AcheronProject/KeebsPCB/README.md

# Acheron 60-SM-S-STM32-MXH-TH-WI (Codename "KeebsPCB")

Acheron Logo

See [this page](https://gondolindrim.github.io/AcheronDocs/keebs/intro.html) for the KeebsPCB documentation.

## Supported layouts

Click [this link](http://www.keyboard-layout-editor.com/#/gists/73be427d3e8086a9253feece2dae6974) for the KLE file for the KeebsPCB.

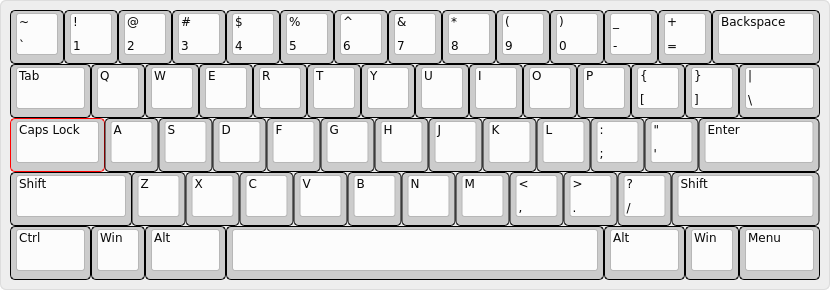
[picture p1: graphics/KLE/keebspcbKLE.png]
Austin layouts


## Renders

Click at the images to zoom in.

Renders generated by the [tracespace.io](https://tracespace.io/view/) site.

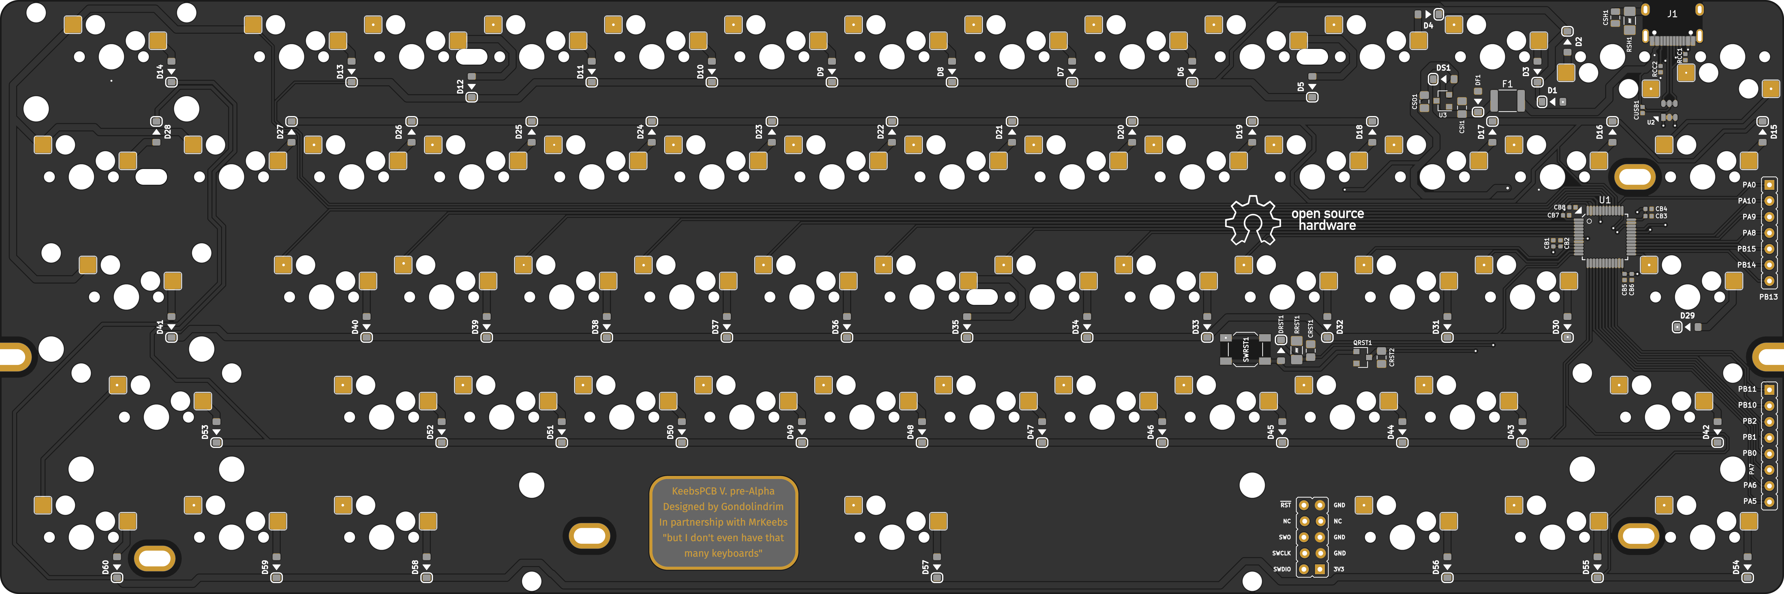
[picture p2: graphics/renders/top.png]
ArcticPCB Top Render


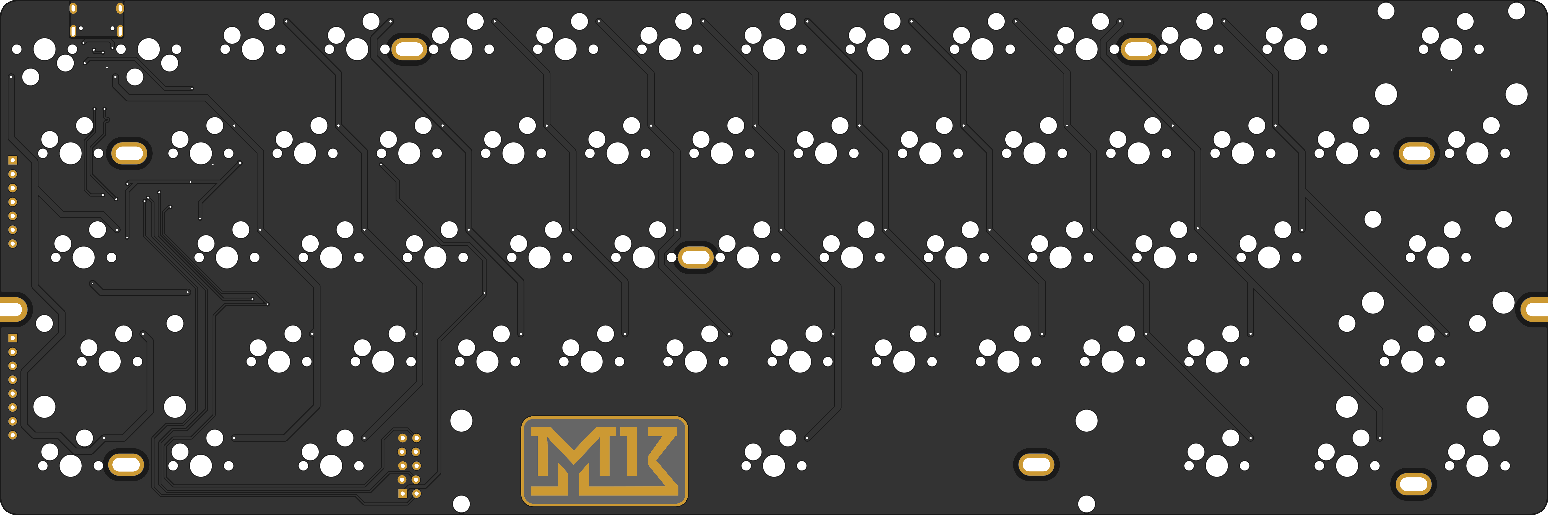
[picture p3: graphics/renders/bottom.png]
ArcticPCB Bottom Render


## Copyright notice

This project is released under the Acheron Open-Hardware License V1.1. For the license, please refer to the LICENCE.md file.
