AcheronProject/KeebsPCB/graphics/keebsLabel/keebsLabel.png

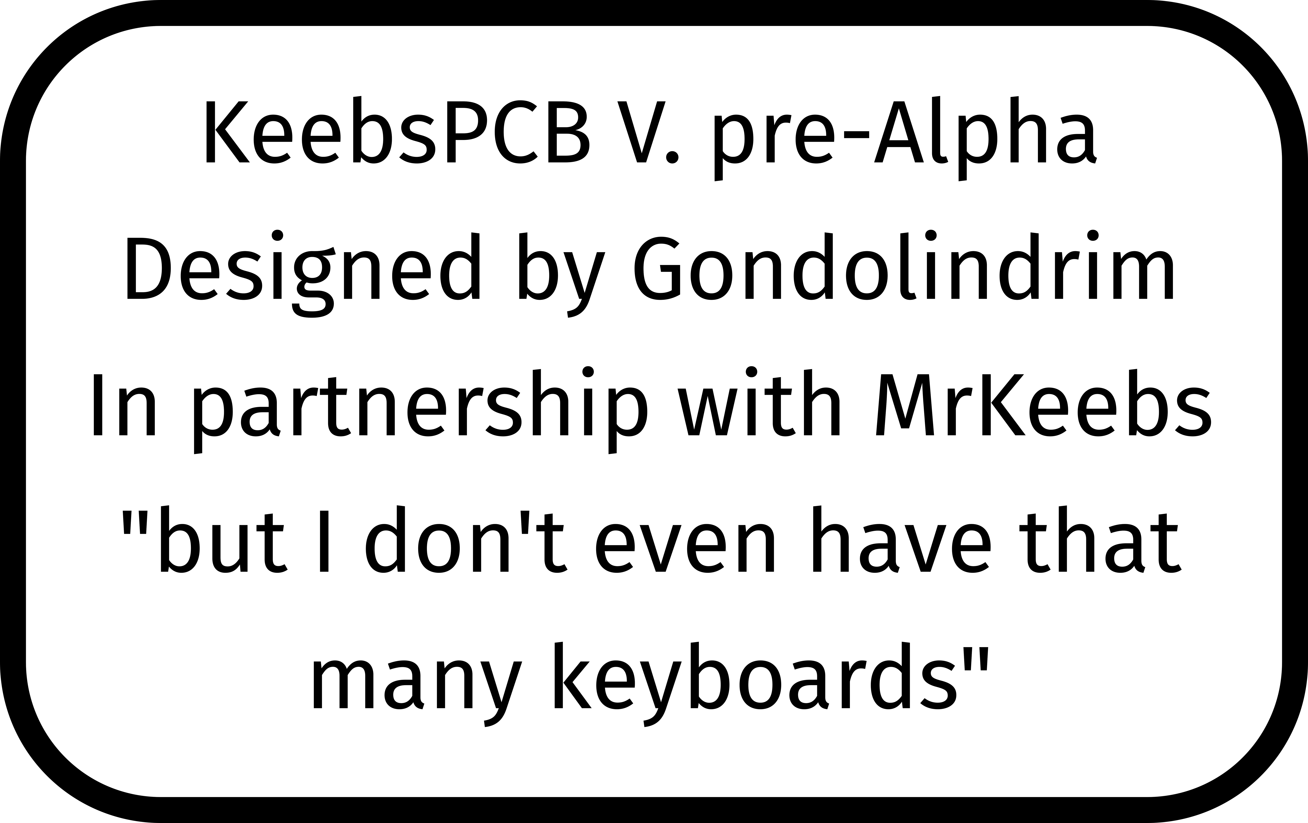
graphics/keebsLabel/keebsLabel.png
