AcheronProject/KeebsPCB/graphics/keebsLabel/keebsLabelMask.png

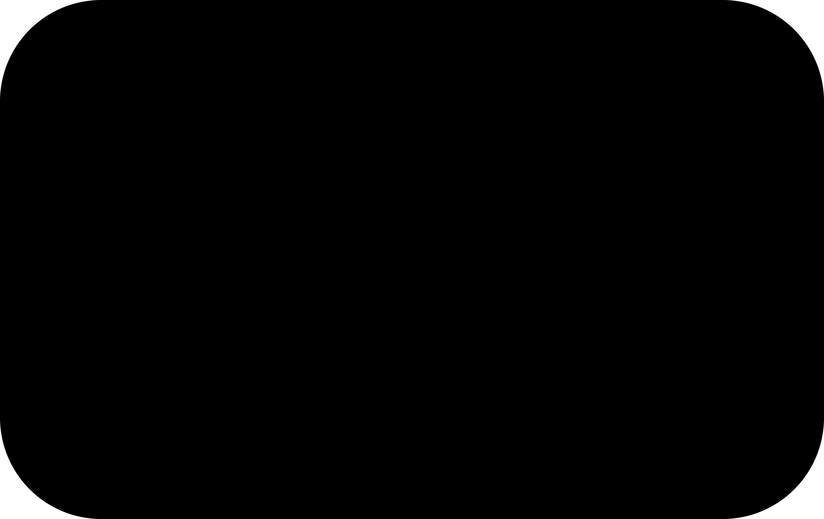
graphics/keebsLabel/keebsLabelMask.png
