AcheronProject/KeebsPCB/resources/keyboardTempEnlarged.dxf

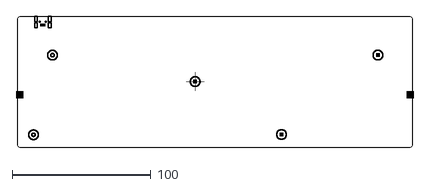
[picture p6: CAD file, 2019-07-31]
resources/keyboardTempEnlarged.dxf
287.2 x 94.7
