AcheronProject/KeebsPCB/resources/60_Keyboard_Case.stl

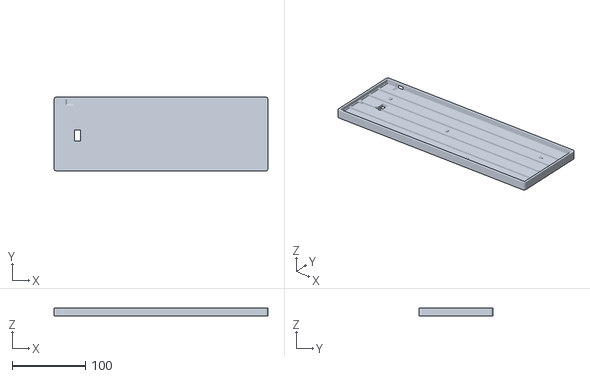
[picture p7: CAD file, 2019-03-15]
resources/60_Keyboard_Case.stl
292.0 x 100.5 x 10.6
