AcheronProject/KeebsPCB/(commit log)

2019-03-15 Started KiCad prokect
    [60_Keyboard_Case.stl, HHKB.brd, HHKB.sch, keebsPCB.kicad_pcb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]
2019-07-31 [Update] Places switches
    [keebsPCB.sch, keyboardTempEnlarged.dxf]
2019-09-23 Update: place connector
    - The USBC connector was placed. In order to accomodate the connector,
    the first two switches (for ESCAPE and 1) had to be rotated.
    [keebsPCB.kicad_pcb]
2019-09-23 Update: adopt new oval back-only mounting holes
    [keebsPCB.kicad_pcb]
2019-09-23 Fix: Dwgs.User issues with MX150H
    [keebsPCB.kicad_pcb]
2019-09-24 Update: fixed layout
    [keebsPCB.kicad_pcb]
2019-09-24 Update: finished routing
    [keebsPCB.kicad_pcb, keebsPCB.sch]
2019-09-25 Update: add label, run DRC
    [keebsPCB.kicad_pcb, keebsPCB.sch]
2019-09-25 Update: README, add renders, add KLE folder
    [keebsPCB.kicad_pcb, keebsPCB.sch]
2019-09-25 Update: SWD JTAG silkscreen updated, renders updated
    [keebsPCB.kicad_pcb]
2019-10-09 Fix plated holes issue
    - There was an issue with some mounting screw holes: some of the overlap
    with pads for the hotswap sockets; these had plated holes that had
    potential unintended short-circuits. Now these holes are not plated
    anymore; only their pads are plated, but not the hole itself.
    [keebsPCB.kicad_pcb]
